Aditya-164/Audio-Amplifier/Hardware images and plot/Band pass filter.jpg

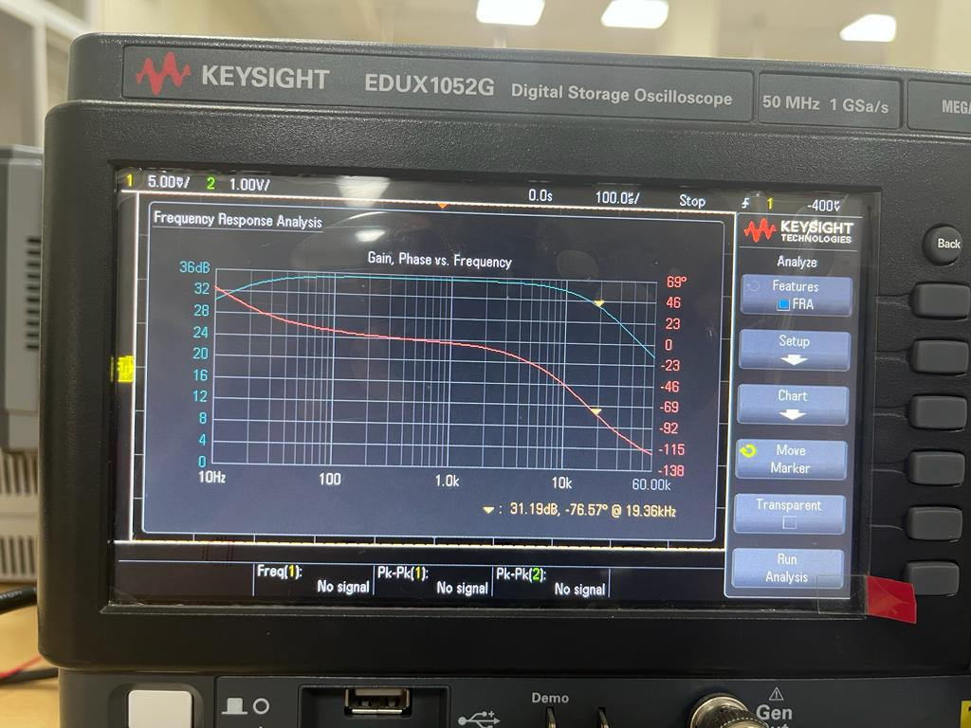
Hardware images and plot/Band pass filter.jpg
