Aditya-164/Audio-Amplifier/Hardware images and plot/2nd stage output.jpg

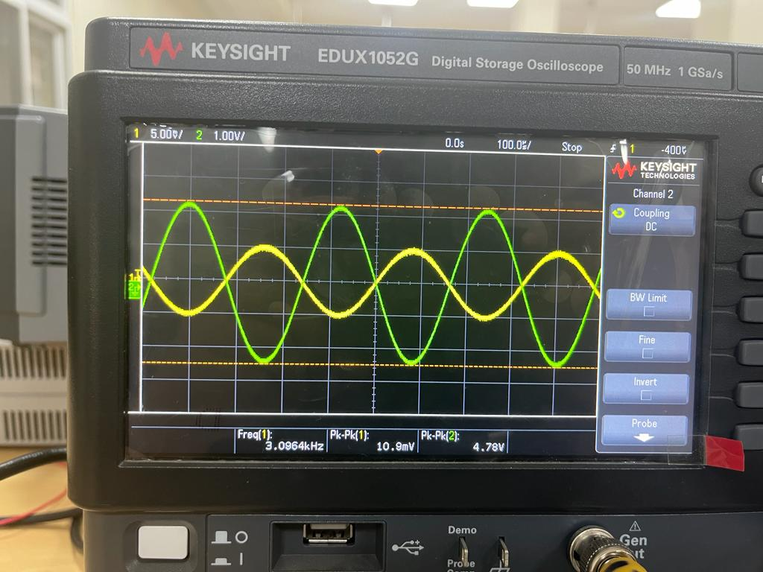
Hardware images and plot/2nd stage output.jpg
