Aditya-164/Audio-Amplifier/Hardware images and plot/1st and 2nd stage.jpg

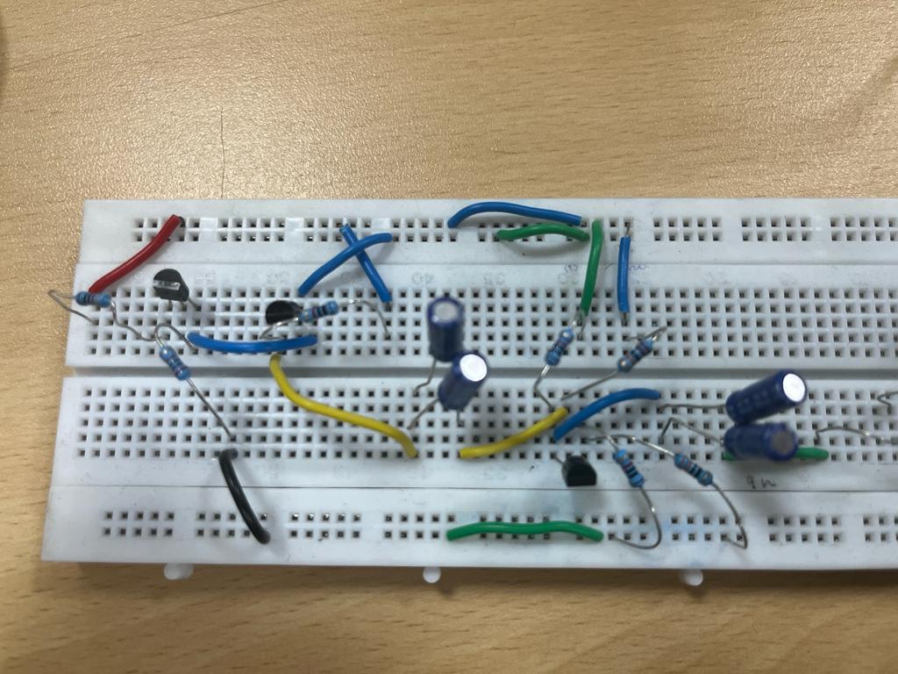
Hardware images and plot/1st and 2nd stage.jpg
