Aditya-164/Audio-Amplifier/Hardware images and plot/1st stage.jpg

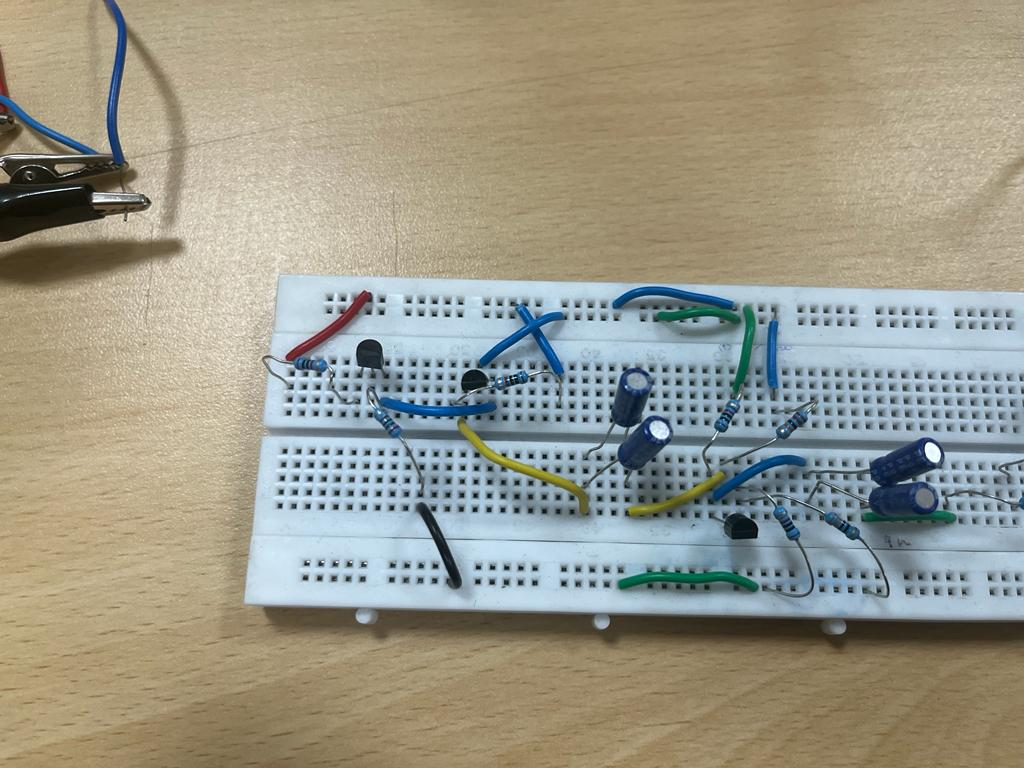
Hardware images and plot/1st stage.jpg
