Aditya-164/Audio-Amplifier/Hardware images and plot/1st,2nd and 3rd stage.jpg

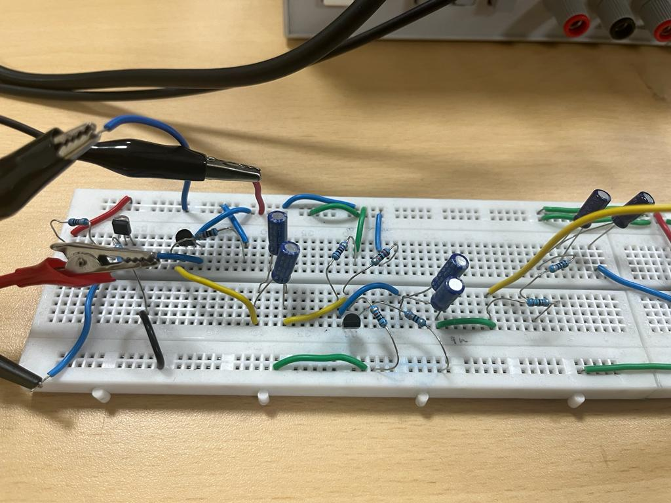
Hardware images and plot/1st,2nd and 3rd stage.jpg
