Aditya-164/Audio-Amplifier/Hardware images and plot/3rd stage output.jpg

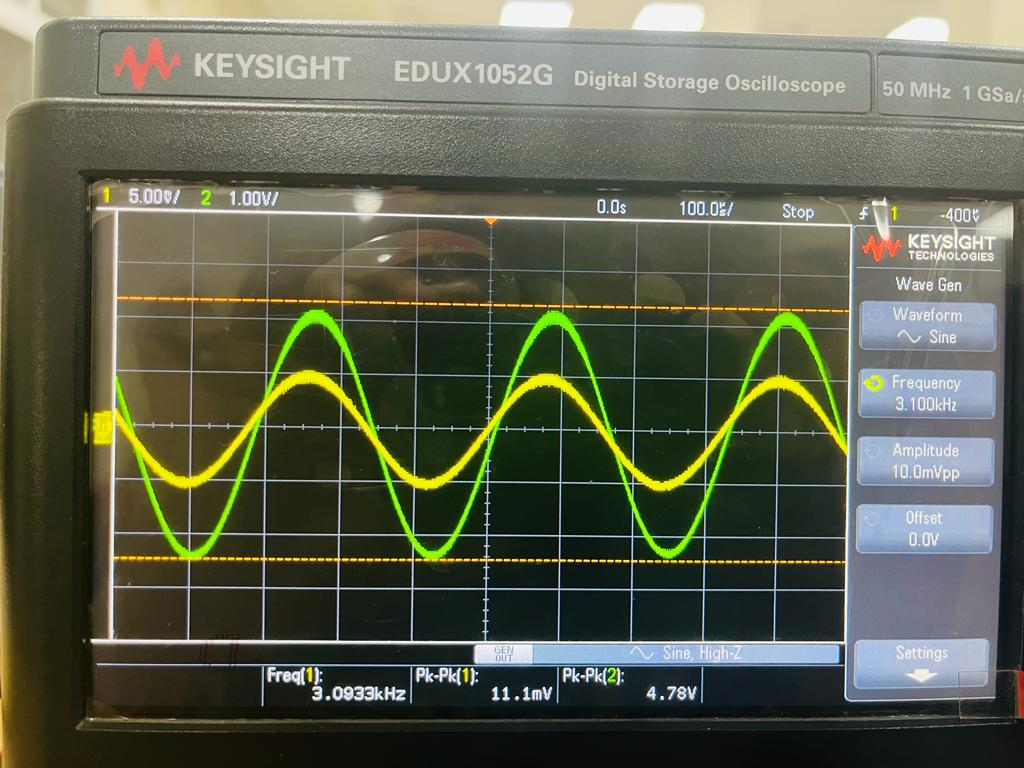
Hardware images and plot/3rd stage output.jpg
