Aditya-164/Audio-Amplifier/Hardware images and plot/Complete circuit.jpg

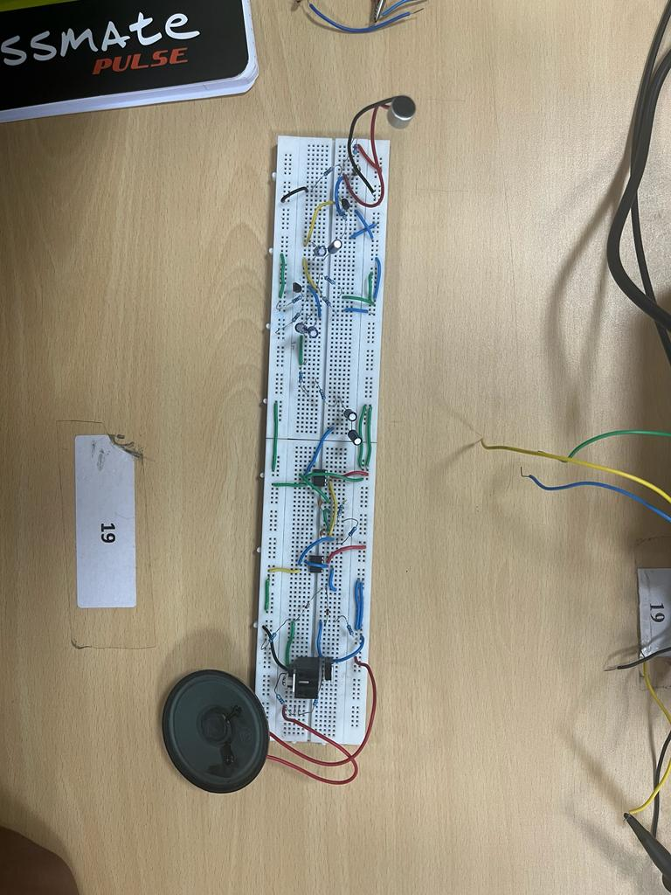
Hardware images and plot/Complete circuit.jpg
