Aditya-164/Audio-Amplifier/Lt_Spice/1st stage-output.jpg

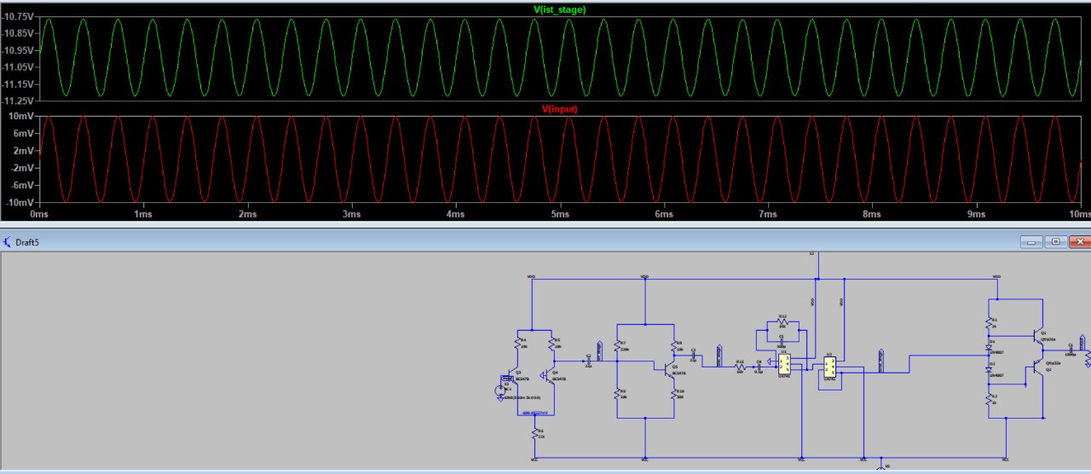
Lt_Spice/1st stage-output.jpg
