Aditya-164/Audio-Amplifier/Lt_Spice/1st stage.jpg

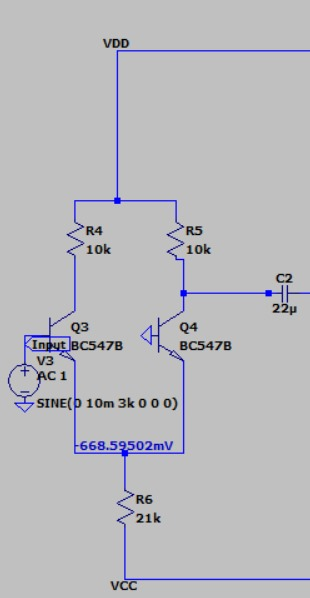
Lt_Spice/1st stage.jpg
