Aditya-164/Audio-Amplifier/Lt_Spice/2nd stage.jpg

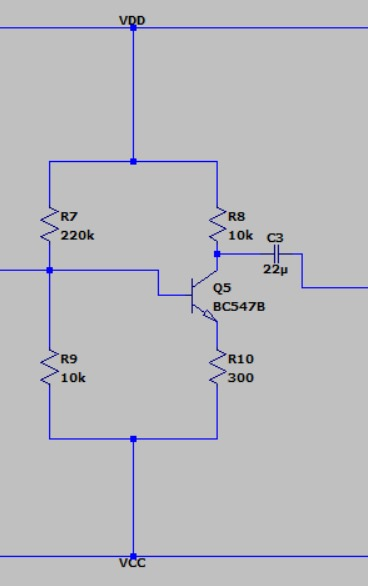
Lt_Spice/2nd stage.jpg
