Aditya-164/Audio-Amplifier/Lt_Spice/3rd stage(band-pass filter) .jpg

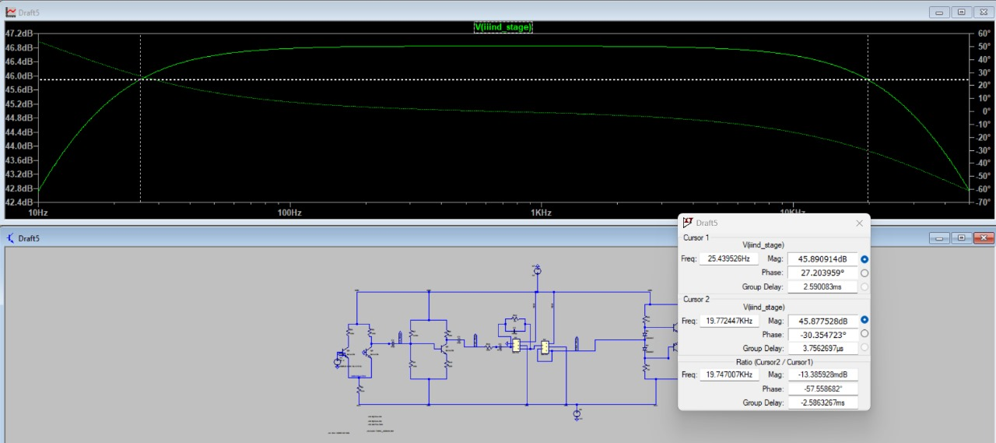
Lt_Spice/3rd stage(band-pass filter) .jpg
