Aditya-164/Audio-Amplifier/Lt_Spice/3rd stage-output.jpg

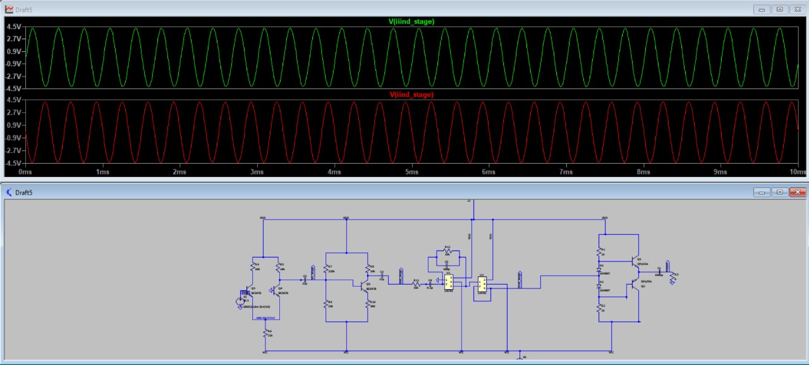
Lt_Spice/3rd stage-output.jpg
