Aditya-164/Audio-Amplifier/Lt_Spice/3rd stage.jpg

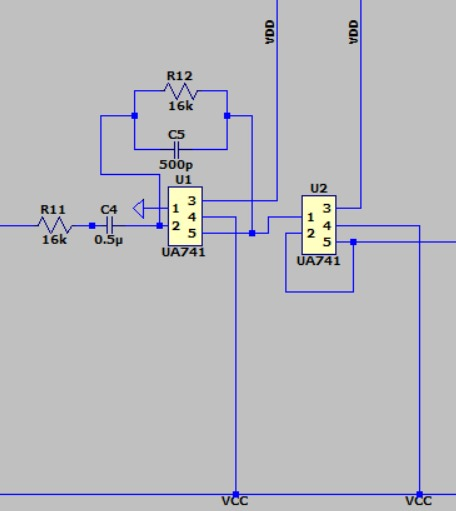
Lt_Spice/3rd stage.jpg
