Aditya-164/Audio-Amplifier/Lt_Spice/Full_circuit.jpg

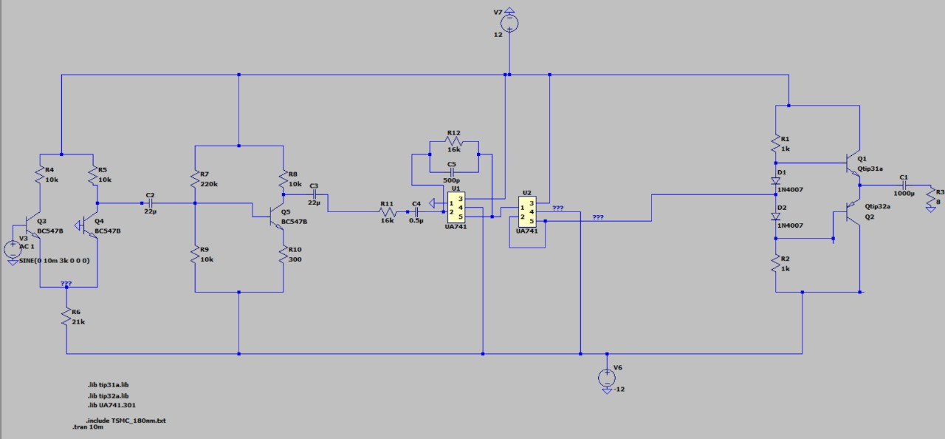
Lt_Spice/Full_circuit.jpg
