Aditya-164/Audio-Amplifier/Lt_Spice/output.jpg

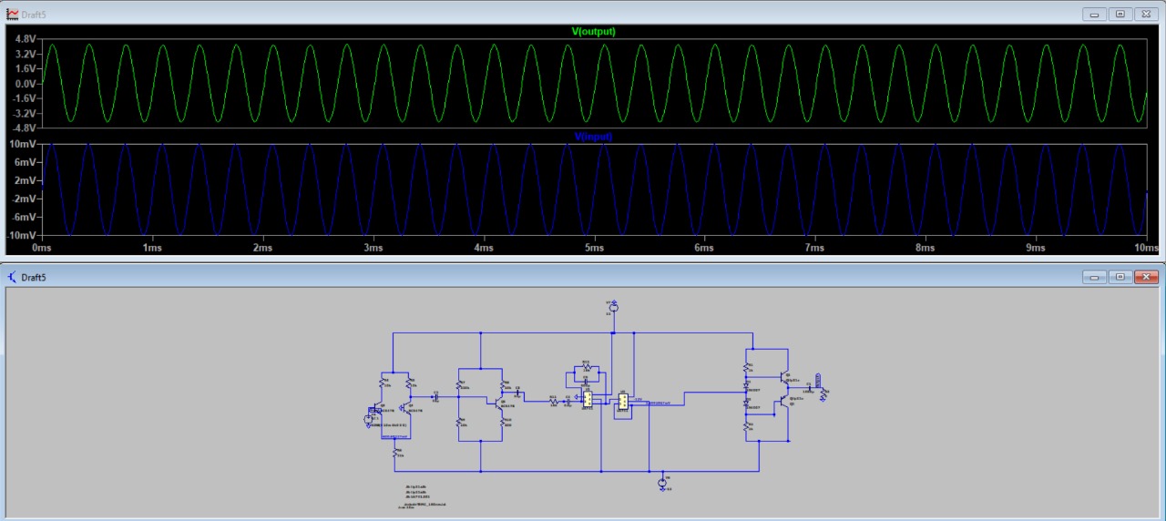
Lt_Spice/output.jpg
