Aditya-164/Audio-Amplifier/Lt_spice_simulation.asc

C1: cap; 1000ľ
C2: cap; 22ľ
C3: cap; 22ľ
C4: cap; 0.5ľ
C5: cap; 500p
D1: diode; 1N4007
D2: diode; 1N4007
Q1: npn; Qtip31a
Q2: pnp; Qtip32a
Q3: npn; BC547B
Q4: npn; BC547B
Q5: npn; BC547B
R1: res; 1k
R2: res; 1k
R3: res; 8
R4: res; 10k
R5: res; 10k
R6: res; 21k
R7: res; 220k
R8: res; 10k
R9: res; 10k
R10: res; 300
R11: res; 16k
R12: res; 16k
U1: UA741
U2: UA741
V3: voltage; SINE(0 10m 3k 0 0 0); AC 1
V6: voltage; -12
V7: voltage; 12
Named nets: 0
.lib UA741.301
.lib tip31a.lib
.lib tip32a.lib
.include TSMC_180nm.txt
.tran 10m
